jack-shirley/Ampduino/images/fuzz waveform 11-19.PNG

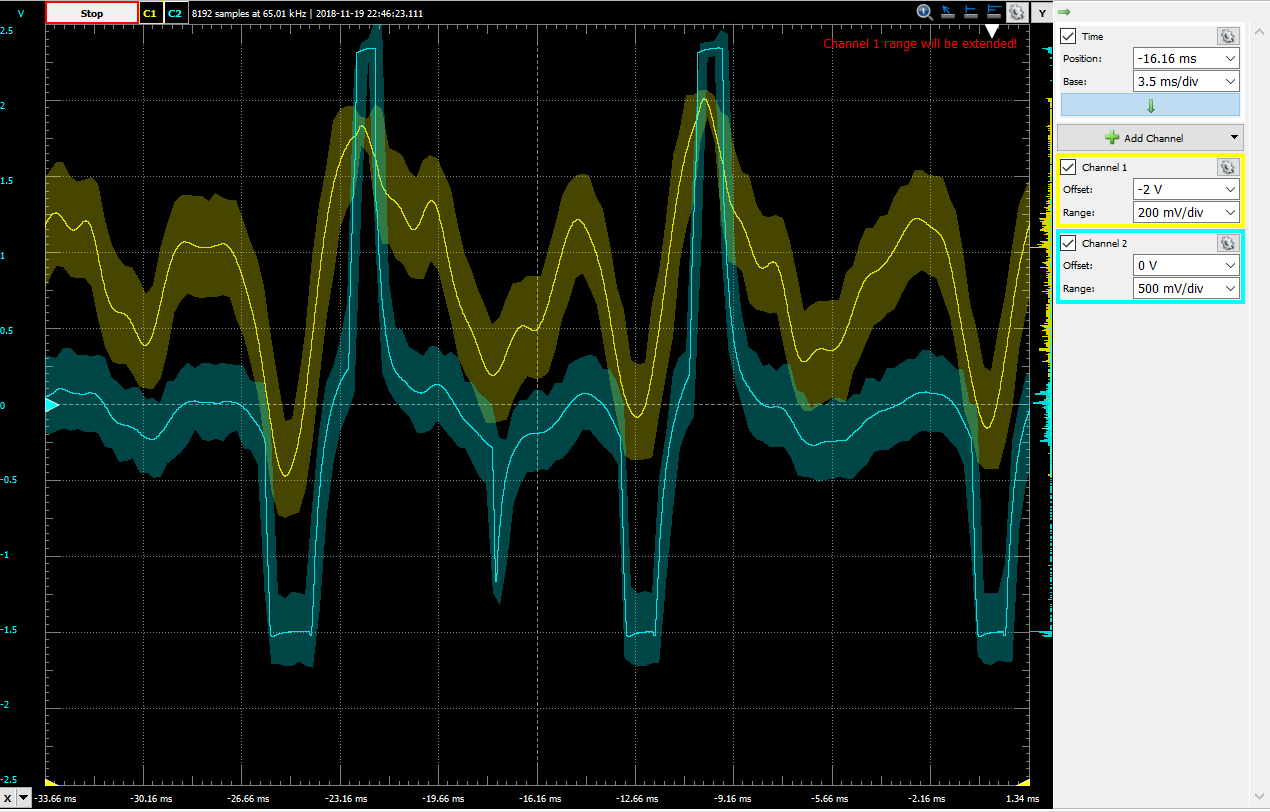
images/fuzz waveform 11-19.PNG
