jack-shirley/Ampduino/(list of files, drawings)

Other design files:
outputguide.ms14
simpleIO.ms14
