jack-shirley/Ampduino/(commit log)

2018-11-06 input and output circuit prototypes
    [outputguide.ms14, simpleIO.ms14]
2018-11-06 bypass capacitors
    [outputguide.ms14, simpleIO.ms14]
2018-11-13 simple input output arduino code, still has noise
    [simpleIO.ms14]
2018-11-15 input stage update
    [simpleIO.ms14]
2018-11-15 loopback - reads A0 and immediately outputs to A11 pwm
2018-11-19 fixed println issue, incorporated output circuit, and added 10-detent pot control
    [outputguide.ms14]
2018-11-19 remove println
2018-11-29 added digital gain stage on distortion/fuzz
2018-11-30 trying to resolve concurrency
    [ampduino.ino]
2018-11-30 connection between arduinos resolved
    [ampduino.ino, controls.ino]
